cookpad/cookpad-pad/production/cookpad-pad-RFQ.xlsx

Sheet: PCB Specs
PCB Specifications
PCB Quantity | 5 pcs
Layer | 2 layers
PCB Thickness | 1.6mm
Dimensions | 57.15 x 38.1 mm
Castellated Hole | No
PCB Color | White
Surface Finish | HASL
Copper Weight | 1oz
Text Color | Black
Different Design | 1

Sheet: BOM
# | Reference | Quantity | Component | Package | Source | Source Part Number | Manufacturer Part Number | Link / Note
1 | C1, C2 | 2 | Ceramic Capacitor, 22pF | 0603 | Elecrow | 2010822A
2 | C3 | 1 | Ceramic Capacitor, 1uF | 0603 | Elecrow | 2013501A
3 | C4, C5 | 3 | Ceramic Capacitor, 0.1uF | 0603 | Elecrow | 2013010A
4 | C6 | 1 | Ceramic Capacitor, 10uF | 0603 | Elecrow | 2015010A
5 | D1, D2, D3, D4, D5, D6 | 6 | Diode, Generic | SOD-123 | Digikey | 1N4148WTPMSCT-ND | 1N4148W-TP | https://www.digikey.com/product-detail/en/micro-commercial-co/1N4148W-TP/1N4148WTPMSCT-ND/717311
6 | U2 | 1 | TVS Diode, 5.5V | SOT143B | Digikey | 1727-3884-1-ND | PRTR5V0U2X,215 | https://www.digikey.com/product-detail/en/nexperia-usa-inc/PRTR5V0U2X215/1727-3884-1-ND/1589981
8 | F1 | 1 | Polyfuse, 500mA hold, 1A trip | 1206 | Digikey | 507-1803-1-ND | 0ZCJ0050AF2E | https://www.digikey.com/product-detail/en/bel-fuse-inc/0ZCJ0050AF2E/507-1803-1-ND/4156312
11 | R6, R3 | 2 | Resistor, 5.1k | 0805 | Digikey | P5.1KDACT-ND | ERA-6AEB512V | https://www.digikey.com/product-detail/en/panasonic-electronic-components/ERA-6AEB512V/P5-1KDACT-ND/1465964
12 | R4, R5 | 2 | Resistor, 22 | 0805 | Digikey | P123893CT-ND | ERA-6AHD220V | https://www.digikey.com/product-detail/en/panasonic-electronic-components/ERA-6AHD220V/P123893CT-ND/9467822
13 | R1, R2 | 2 | Resistor, 10k | 0805 | Digikey | P10KDACT-ND | ERA-6AEB103V | https://www.digikey.com/product-detail/en/panasonic-electronic-components/ERA-6AEB103V/P10KDACT-ND/1465971
14 | SW1 | 1 | Low Profile Tactile Switch | 5.2x5.2mm | Digikey | CKN10361CT-ND | RS-187R05A2-DS MT RT | https://www.digikey.com/product-detail/en/c-k/RS-187R05A2-DS-MT-RT/CKN10361CT-ND/2747199
15 | U1 | 1 | ATMEGA32U2 Microcontroller | 32-TQFP 7x7mm | Digikey | ATMEGA32U2-AU-ND | ATMEGA32U2-AU | https://www.digikey.com/product-detail/en/microchip-technology/ATMEGA32U2-AU/ATMEGA32U2-AU-ND/2187167
16 | Y1 | 1 | Crystal, 16MHz | 3.2x2.5mm, 4 pad | Digikey | 1253-1698-1-ND | CX3225SB16000D0GZJC1 | https://www.digikey.com/product-detail/en/CX3225SB16000D0GZJC1/1253-1698-1-ND/5995245/
17 | USB1 | 1 | HRO-TYPE-C-31-M-12 | 8.94x7.3mm | LCSC | C165948 | TYPE-C-31-M-12 | https://lcsc.com/product-detail/USB-Type-C_Korean-Hroparts-Elec-TYPE-C-31-M-12_C165948.html

Sheet: Position File
Designator | Pacakge | Center-X(mm) | Center-Y(mm) | Layer | Rotation
C1 | 0603 | -89.408 | -48.768 | bottom | 180
C2 | 0603 | -89.408 | -50.546 | bottom | 180
C3 | 0603 | -73.8187 | -44.45 | bottom | 90
C4 | 0603 | -86.614 | -45.847 | bottom | 90
C5 | 0603 | -81.534 | -44.577 | bottom | 90
C6 | 0603 | -85.598 | -53.086 | bottom | 0
D1 | SOD-123 | -62.7062 | -46.0375 | bottom | 90
D2 | SOD-123 | -65.8812 | -46.0375 | bottom | 90
D3 | SOD-123 | -92.8687 | -46.0375 | bottom | 90
D4 | SOD-123 | -62.7062 | -51.5938 | bottom | 90
D5 | SOD-123 | -65.8812 | -51.5938 | bottom | 90
D6 | SOD-123 | -92.8687 | -51.5938 | bottom | 90
F1 | 1206 | -84.455 | -45.085 | bottom | 90
R1 | 0805 | -78.994 | -59.3725 | bottom | 90
R2 | 0805 | -76.708 | -59.3725 | bottom | 270
R3 | 0805 | -70.485 | -33.274 | bottom | 0
R4 | 0805 | -76.2 | -44.45 | bottom | 90
R5 | 0805 | -79.375 | -44.45 | bottom | 90
R6 | 0805 | -84.9312 | -33.3375 | bottom | 180
SW1 | SW_Push | -77.7875 | -64.2938 | bottom | 180
U1 | ATmega32U2-AU | -77.7875 | -51.5938 | bottom | 180
U2 | PRTR5V0U2X | -77.7875 | -41.148 | bottom | 180
USB1 | HRO-TYPE-C-31-M-12 | -77.7875 | -29.718 | bottom | 0
Y1 | 16MHz | -85.852 | -50.038 | bottom | 270
