cookpad/cookpad-pad/plate/switch-plate.dxf

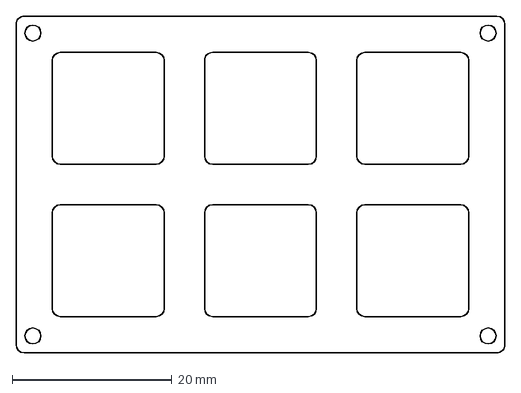
[picture p2: CAD file, 2020-09-10]
plate/switch-plate.dxf
61.2 x 42.1 mm
