cookpad/cookpad-pad/plate/bottom-plate.dxf

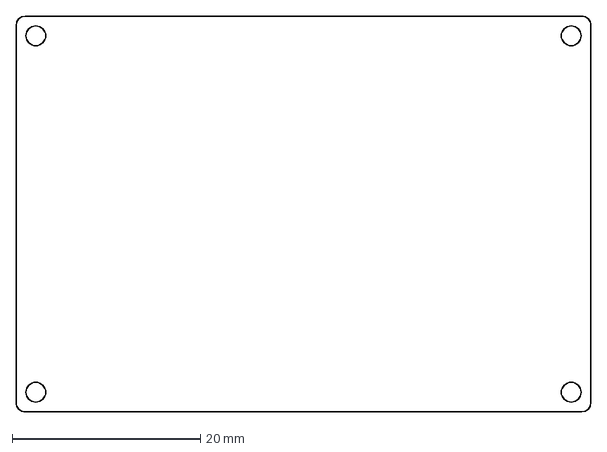
[picture p3: CAD file, 2020-09-10]
plate/bottom-plate.dxf
61.2 x 42.1 mm
