cookpad/cookpad-pad/plate/plate.dxf

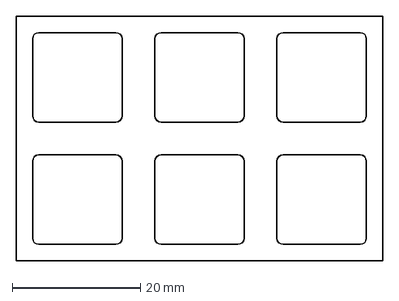
[picture p4: CAD file, 2020-09-10]
plate/plate.dxf
57.1 x 38.1 mm
