cookpad/cookpad-pad/pcb/cookpad-pad.kicad_pcb

## KiCad design pcb/cookpad-pad.kicad_pcb (2020-09-10)

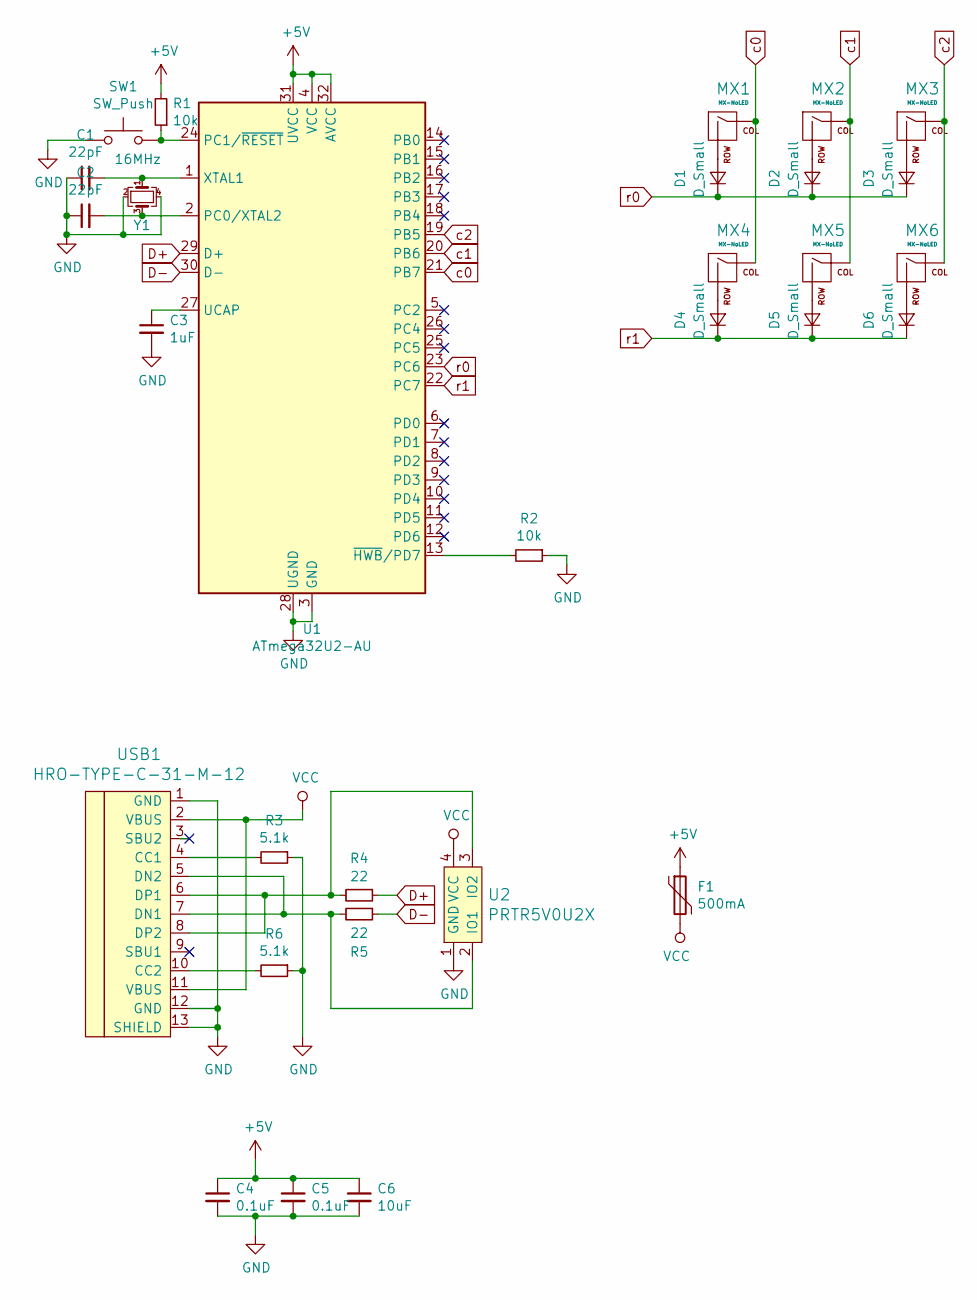
[picture p5: schematic cookpad-pad.sch]

Parts:
C1, C2: 22pF; C_0603_1608Metric
C3: 1uF; C_0603_1608Metric
C4, C5: 0.1uF; C_0603_1608Metric
C6: 10uF; C_0603_1608Metric
D1, D2, D3, D4, D5, D6: D_Small; D_SOD-123
F1: 500mA; Fuse_1206_3216Metric
MX1, MX2, MX3, MX4, MX5, MX6: MX-NoLED; MXOnly-1U-NoLED
R1, R2: 10k; R_0805_2012Metric
R3, R6: 5.1k; R_0805_2012Metric
R4, R5: 22; R_0805_2012Metric
SW1: SW_Push; SKQG-1155865
U1: ATmega32U2-AU; TQFP-32_7x7mm_P0.8mm
U2: PRTR5V0U2X; SOT143B
USB1: HRO-TYPE-C-31-M-12; HRO-TYPE-C-31-M-12-Assembly
Y1: 16MHz; Crystal_SMD_3225-4Pin_3.2x2.5mm

Connections:
+5V: C4.1, C5.1, C6.1, F1.1, R1.2, U1.4 (VCC), U1.31 (UVCC), U1.32 (AVCC)
D+: R4.1, U1.29 (D+)
D-: R5.1, U1.30 (D-)
GND: C1.1, C2.1, C3.2, C4.2, C5.2, C6.2, R2.1, R3.1, R6.1, SW1.1, U1.3 (GND), U1.28 (UGND), U2.1 (GND), USB1.1 (GND), USB1.12 (GND), USB1.13 (SHIELD), Y1.2, Y1.4
unnamed: C1.2, U1.1 (XTAL1), Y1.1
unnamed: C2.2, U1.2 (PC0/XTAL2), Y1.3
unnamed: C3.1, U1.27 (UCAP)
unnamed: D1.2 (A), MX1.2 (ROW)
unnamed: D2.2 (A), MX2.2 (ROW)
unnamed: D3.2 (A), MX3.2 (ROW)
unnamed: D4.2 (A), MX4.2 (ROW)
unnamed: D5.2 (A), MX5.2 (ROW)
unnamed: D6.2 (A), MX6.2 (ROW)
unnamed: R1.1, SW1.2, U1.24 (PC1/~RESET)
unnamed: R2.2, U1.13 (~HWB~/PD7)
unnamed: R3.2, USB1.4 (CC1)
unnamed: R4.2, U2.3 (IO2), USB1.6 (DP1), USB1.8 (DP2)
unnamed: R5.2, U2.2 (IO1), USB1.5 (DN2), USB1.7 (DN1)
unnamed: R6.2, USB1.10 (CC2)
VCC: F1.2, U2.4 (VCC), USB1.2 (VBUS), USB1.11 (VBUS)
c0: MX1.1 (COL), MX4.1 (COL), U1.21 (PB7)
c1: MX2.1 (COL), MX5.1 (COL), U1.20 (PB6)
c2: MX3.1 (COL), MX6.1 (COL), U1.19 (PB5)
r0: D1.1 (K), D2.1 (K), D3.1 (K), U1.23 (PC6)
r1: D4.1 (K), D5.1 (K), D6.1 (K), U1.22 (PC7)

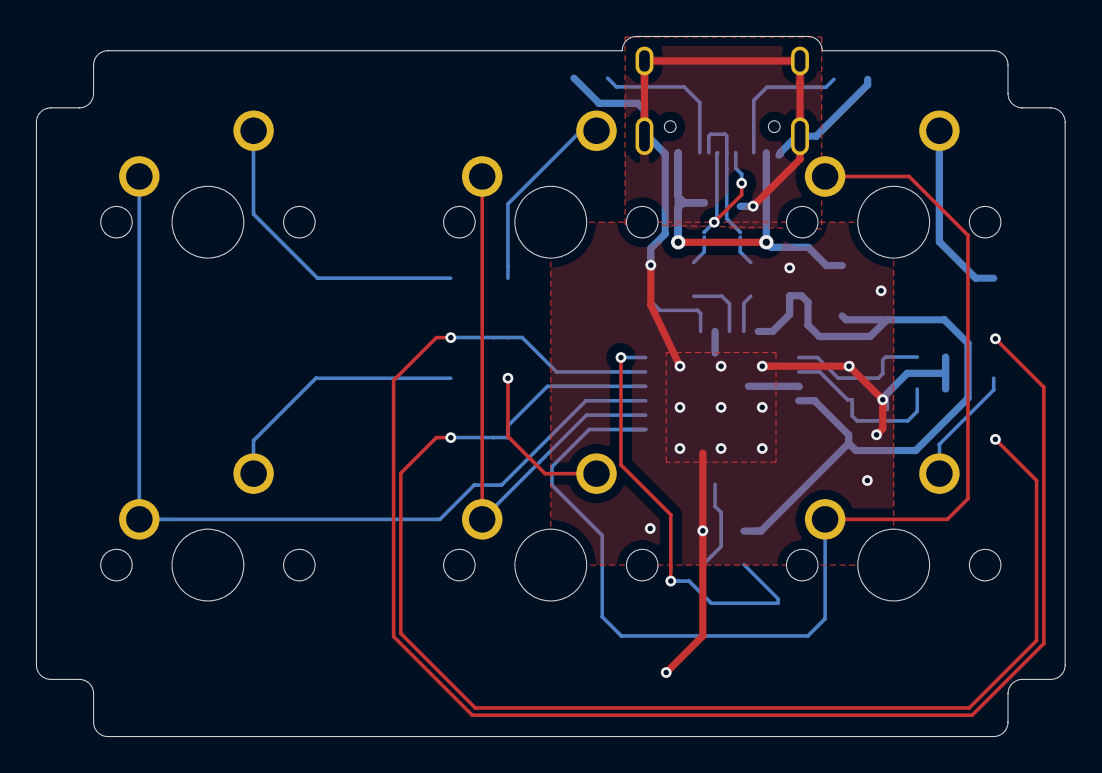
[picture p6: board cookpad-pad.kicad_pcb from above]

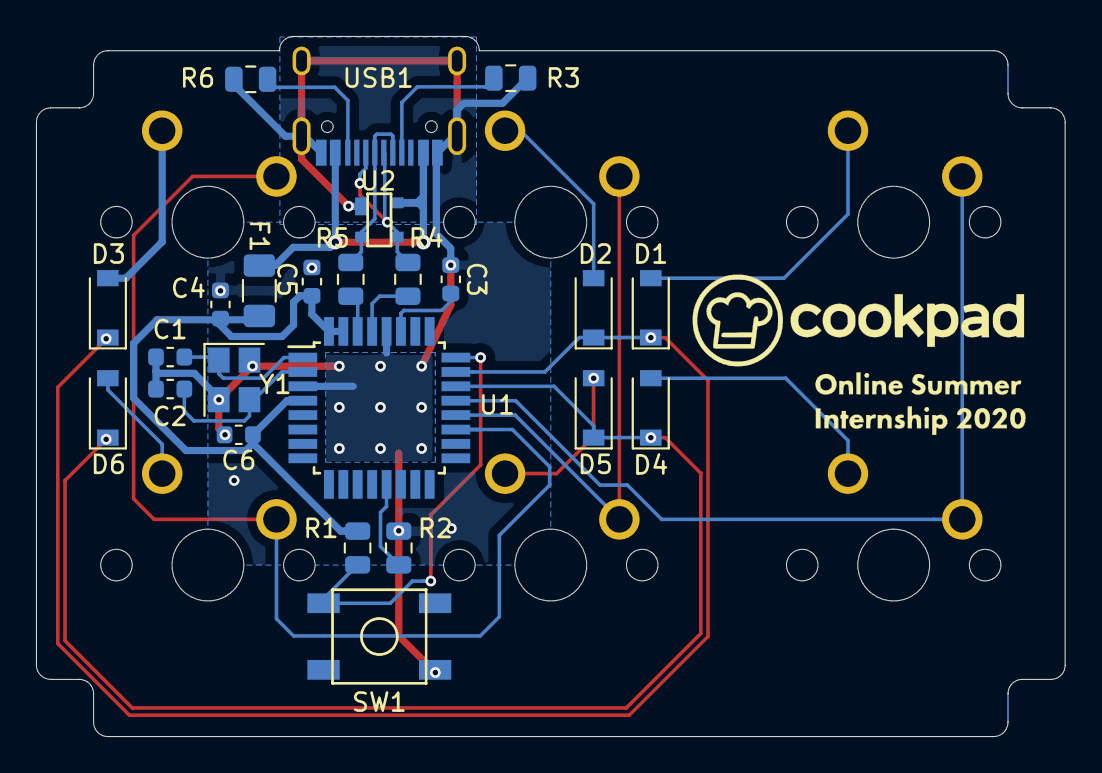
[picture p7: board cookpad-pad.kicad_pcb from below]

Board: 2 copper layers, 57.2 x 38.9 mm, 30 parts (24 on the bottom side), 25 nets.
