cookpad/cookpad-pad/docs/build-guide-ja.md

# Cookpad Pad 2 組立方法

## 同梱品について

名称 | 数量
---- | ----
PCB | 1
スイッチプレート | 1
ボトムプレート | 1
M2 ネジ | 8
M2 スペーサー | 4
キーキャップ | 6
キースイッチ | 6

## 組立手順

### キースイッチをスイッチプレートに固定する

キースイッチをスイッチプレートの穴に差し込み、固定します。プレートに上下や表裏はありません。スイッチには方向がありますので、スイッチ上部ケースにロゴがある方向を奥側にします。

### キースイッチをPCBに固定する

スイッチを固定したスイッチプレートを裏返し、PCBを差し込みます。PCBに電子部品が実装されている側が外側にくるようにしてください。多少きついかもしれませんが、PCBとスイッチの間に隙間がないようにしっかりと差し込みます。それから、PCBのスルーホールからスイッチの足が出ていることを確認してください。

### キースイッチをはんだ付けする

キースイッチをはんだ付けします。はんだ付けのコツは、温度調整機能付きのはんだこてを使うことです。
### ボトムプレートをとりつける

スイッチプレートに M2 スペーサーと M2 ねじを取り付け、さらにボトムプレートも M2 ねじで取り付けます。

### キーキャップをとりつける

最後にキーキャップを取り付けて完成です。

## キーマップを変更する

Cookpad Pad 2のキーマップは、VIAというソフトウェアを利用して自由に変更することができます。

1. [VIA](https://caniusevia.com/) をダウンロード
2. [キーマップファイル](https://raw.githubusercontent.com/takai/qmk_firmware/cookpad-pad2/keyboards/cookpad_pad/cookpad_pad.json) をダウンロードする
3. VIAを起動し、メニューから Import Keymap を実行し、さきほどダウンロードしたファイルを読み込む

## 参考情報

- [キーボード情報源 2020 - たのしい人生](https://biacco42.hatenablog.com/entry/2020/07/21/201148)
- [自作キーボードを作るために必要なもの - 自作キーボード温泉街の歩き方](https://salicylic-acid3.hatenablog.com/entry/2018/11/24/自作キーボードを作るために必要なもの)
- [店舗情報・工作室 | 遊舎工房](https://yushakobo.jp/shopinfo/)
    - はんだなど、組立に必要な一式がそろっていてるので、その場でキーボードを組み立てることができます。
