cookpad/cookpad-pad/(threads)

Thread 2 (2019-10-25):

diode / matrix

l4u, 2019-10-25:
Interesting project! A minor issue is, I believe the diodes / matrix shouldn't be required because of the small number of keys.

takai, 2020-09-03:
Thank you for your comment and I'm sorry for the late reply.

You are right that a key matrix is not required at this size. However, when someone creates another implementation based on this project, they will need it.

That's why Cookpad Pad uses a key matrix.

Closed 2020-09-03.
