cookpad/cookpad-pad/(commit log)

2020-09-10 Add pcb
    [cookpad-pad.kicad_pcb, cookpad-pad.sch]
2020-09-10 Add plate files
    [bottom-plate.dxf, plate.dxf, switch-plate.dxf]
2020-09-10 Add files for production
    [cookpad-pad-RFQ.xlsx]
